rdelpoux/ESP32Robot/PCB/PCBdesign.md

# PCB design

## ESP 32

The chosen ESP32 is a ESP32-WROOM-32D and the datasheet is available [here](https://github.com/rdelpoux/ESP32Robot/blob/main/PCB/datasheets/esp32_wroom_32d_esp32_wroom_32u_datasheet_en-1365844.pdf). 

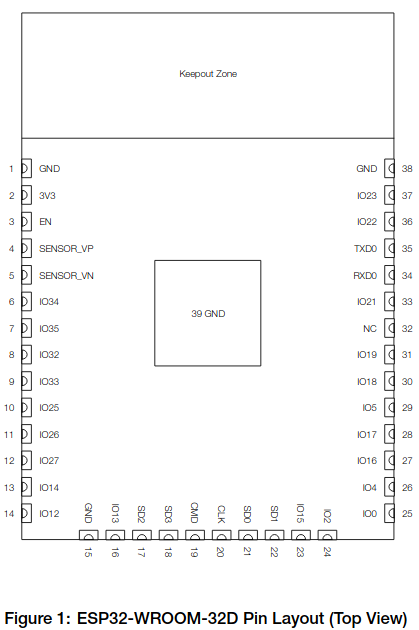
[picture p6: img/ESP32-WROOM-32D_Pin_Layout.png]


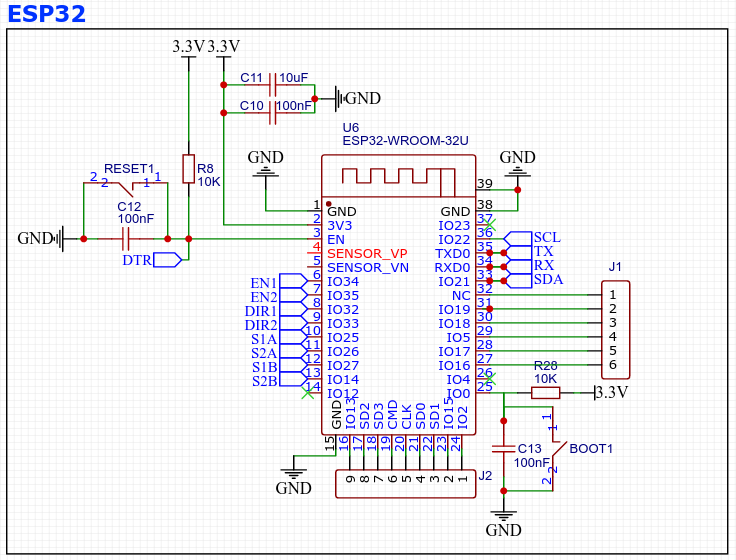
[picture p7: img/ESPPinout.png]
PinLayoutSheme


## Program upload

It was chosen to upload the program on the ESP32 using an [USB UART cable with FTDI chip](https://fr.rs-online.com/web/p/cables-raspberry-pi/7676200/). 

## Dual half bridge

The dual half bridge datasheet can be found [here](https://github.com/rdelpoux/ESP32Robot/blob/main/PCB/datasheets/pmoddhb1_sch.pdf).

The dual half bridge can be connected to the PCB. Pmod port is an open 12-pin interface arranged in 2 rows of 6 pins. The PCB include the following connector :  

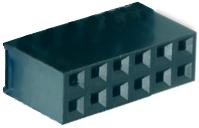
[picture p8: img/pmod.png]


The pins are arranged as : 

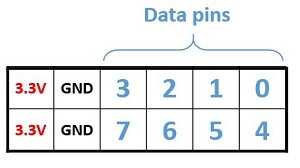
[picture p9: img/pmod_pins.jpeg]


For the Dual half bridge, the pins are the following :

| Data pins | Motor 1 | Data pins | Motor 2 |
| --- | --- | --- | --- |
| 0 | EN1 | 4 | EN2 |
| 1 | DIR1 | 5 | DIR2 |
| 2 | S1A | 6 | S2A |
| 3 | S1B | 7 | S2B |

## Battery Management

The system is powered by a [7.4V Lithium-Ion 2.6Ah](https://fr.rs-online.com/web/p/blocs-batteries-rechargeables/1449410/) battery. The PCB embed a battery charger. 

Charger example :

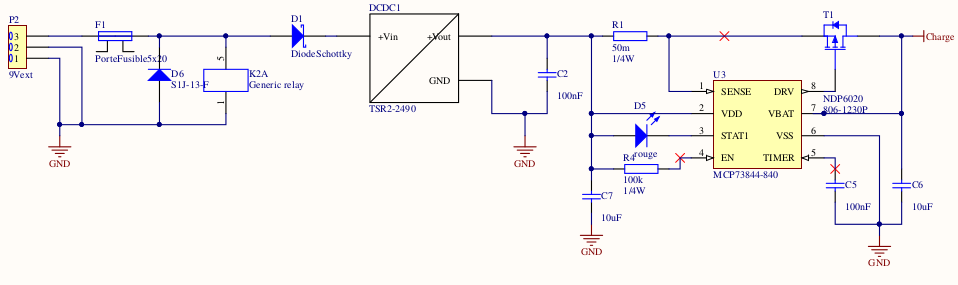
[picture p10: img/ChargeurBatterie.png]
