rdelpoux/ESP32Robot/SystemDescription.md

[Back to main page](/README.md)

# System description 

Dual-brige

[Back to main page](/README.md)

## System

The system is composed of 

- [2A-H-bridge](https://reference.digilentinc.com/reference/pmod/pmodhb5/reference-manual)

Dual-brige

- [Two motors with encoders](https://store.digilentinc.com/dc-motor-gearbox-1-53-gear-ratio-custom-6v-motor-designed-for-digilent-robot-kits/)

motor

- [7.4V Lithium-Ion 2.6Ah](https://fr.rs-online.com/web/p/blocs-batteries-rechargeables/1449410/) battery

- [Motor support](https://www.lextronic.fr/support-pour-moteurs-30627.html)

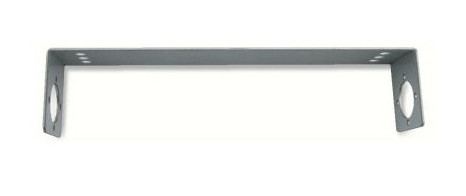
[picture p20: img/support-pour-moteurs.jpg]
support


- [Motor hubs](https://www.lextronic.fr/moyeux-pour-moteurs-pololu-30809.html)

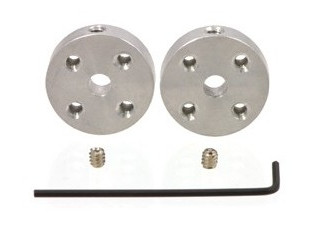
[picture p21: img/moyeux-pour-moteurs-pololu.jpg]
moyeux


- [60 mm wheels](https://www.lextronic.fr/paire-de-roues-diametre-60-mm-30817.html)

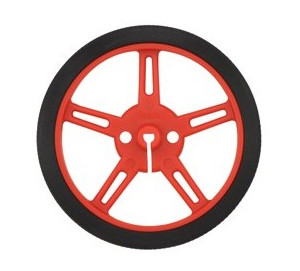
[picture p22: img/paire-de-roues-diametre-60-mm.jpg]
wheel


- [Free wheel](https://www.manomano.fr/catalogue/p/litzee-transfert-a-billes-roulettes-pour-meubles-roulettes-transfert-a-rouleaux-unites-de-transfert-a-billes-fer-galvanise-avec-b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)

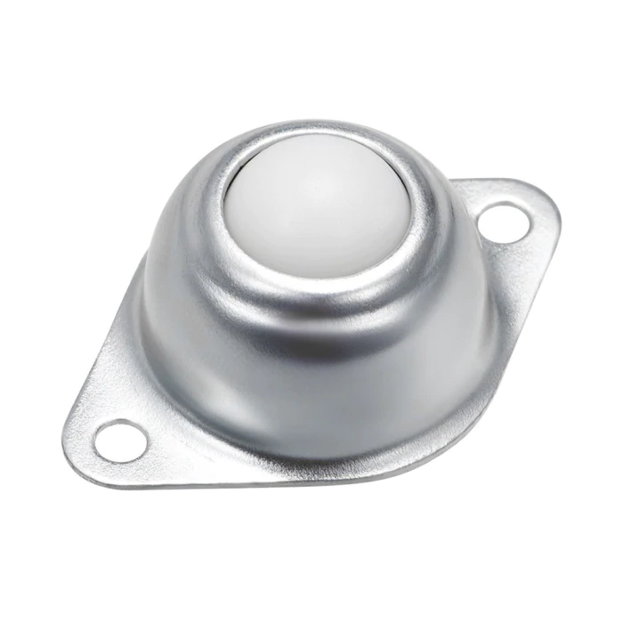
[picture p23: img/free-wheel.jpg]
free-wheel


[Back to main page](/README.md)

## Controller board

The chosen ESP32 is a ESP32-WROOM-32D and the datasheet is available [here](https://www.espressif.com/sites/default/files/documentation/esp32-wroom-32e_esp32-wroom-32ue_datasheet_en.pdf). It was  mounted on a custom PCB.

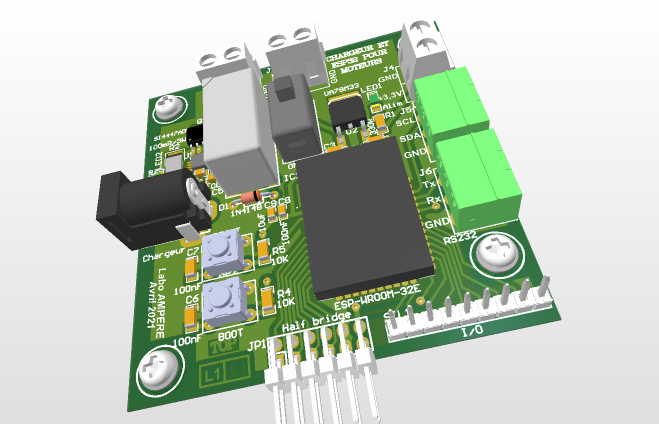
[picture p24: img/Chargeur_ESP32.png]


The PCB features are the following :

- Drive 2 DC motors
- Read 2 DC motors encoder
- Charge Battery

### PCB description

The principle scheme of the PCB is :

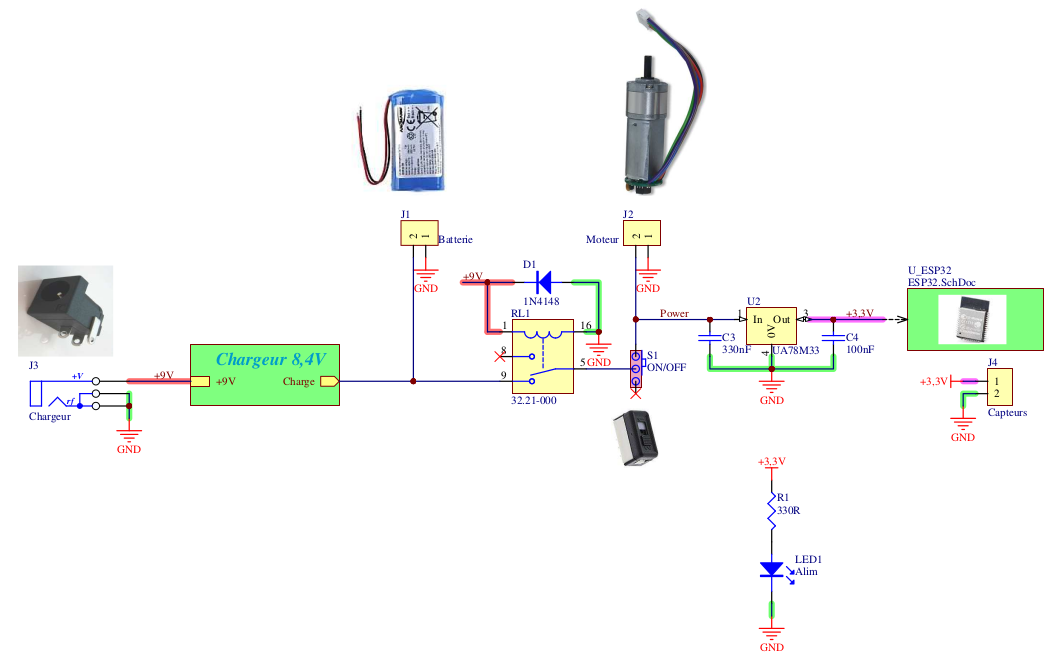
[picture p25: img/PCBPrinciple.png]


Specifically, the routing of the ESP 32 is 

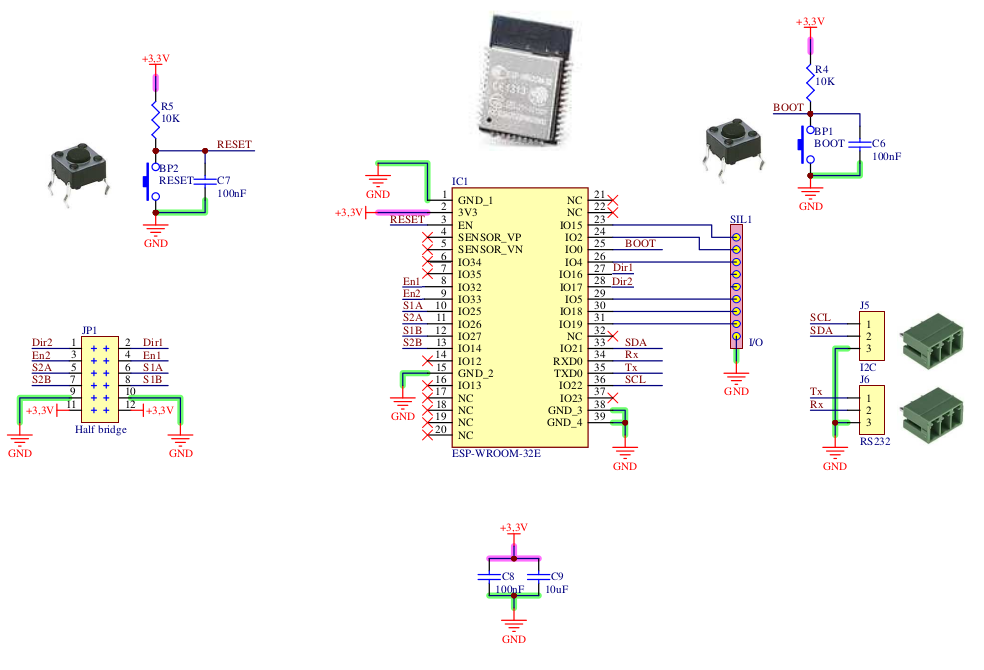
[picture p26: img/ESPMod.png]


### Pinout

| Name | Description | ESP32  Pinout |
| ---- | --- | --- |
| Dir1 | Motor 1 direction (0 forward, 1 reverse) | IO16 |
| Dir2 | Motor 2 direction (0 forward, 1 reverse) | IO17 |
| En1  | Enable motor 1 (PWM) | IO32 |
| En2  | Enable motor 2 (PWM) | IO33 |
| S1A  | Motor 1 Sensor A feedback pin | IO25 |
| S1B  | Motor 1 Sensor B feedback pin | IO27 |
| S2A  | Motor 2 Sensor A feedback pin | IO26 |
| S2B  | Motor 2 Sensor B feedback pin | IO14 |

### Program Upload

It was chosen to upload the program on the ESP32 using an [USB UART cable with FTDI chip](https://fr.rs-online.com/web/p/cables-raspberry-pi/7676200/). 

When try to upload a new sketch to your ESP32 in the Arduino IDE, it may fail to connect to your board saying ‘**A fatal error occurred: Failed to connect to ESP32: Timed out waiting for packet header**’.

Dual-brige

Hold-down the **RESET** and **BOOT** button in your ESP32 board, then release  **RESET** then **BOOT** button. The ESP32 enters **BOOT** mode. After uploading a new sketch, press the **RESET** button to restart the ESP32 and run the new uploaded sketch.

[Back to main page](/README.md)

## Sources 

- [https://lastminuteengineers.com/esp32-arduino-ide-tutorial/](https://lastminuteengineers.com/esp32-arduino-ide-tutorial/)

[Back to main page](/README.md)
