rdelpoux/ESP32Robot/img/encoder.jpg

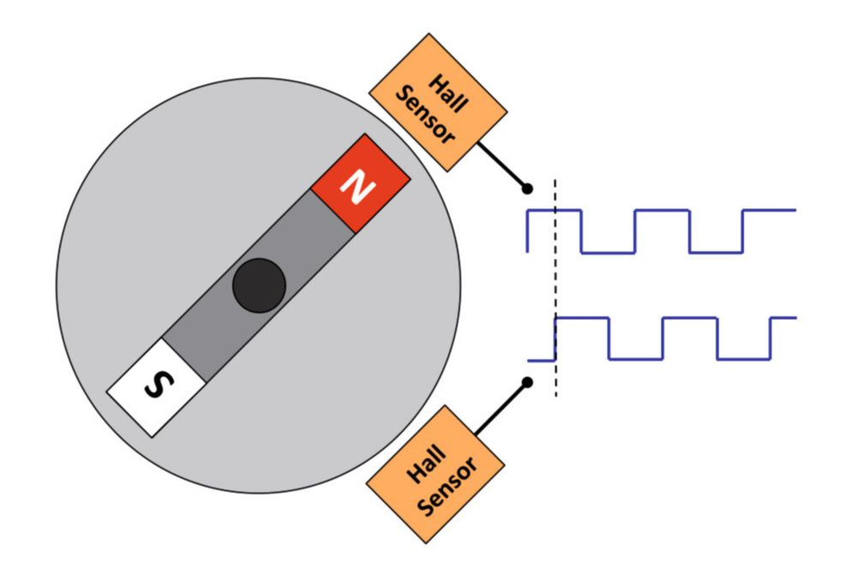
img/encoder.jpg
