rdelpoux/ESP32Robot/img/hbridge_logic_enable.png

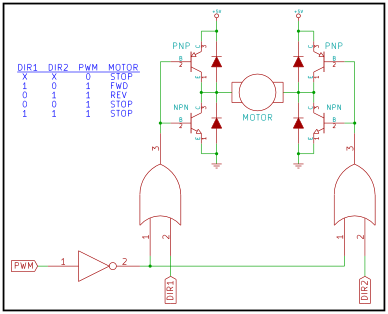
img/hbridge_logic_enable.png
