rdelpoux/ESP32Robot/img/moteur-reducteur-avec-encodeur.jpg

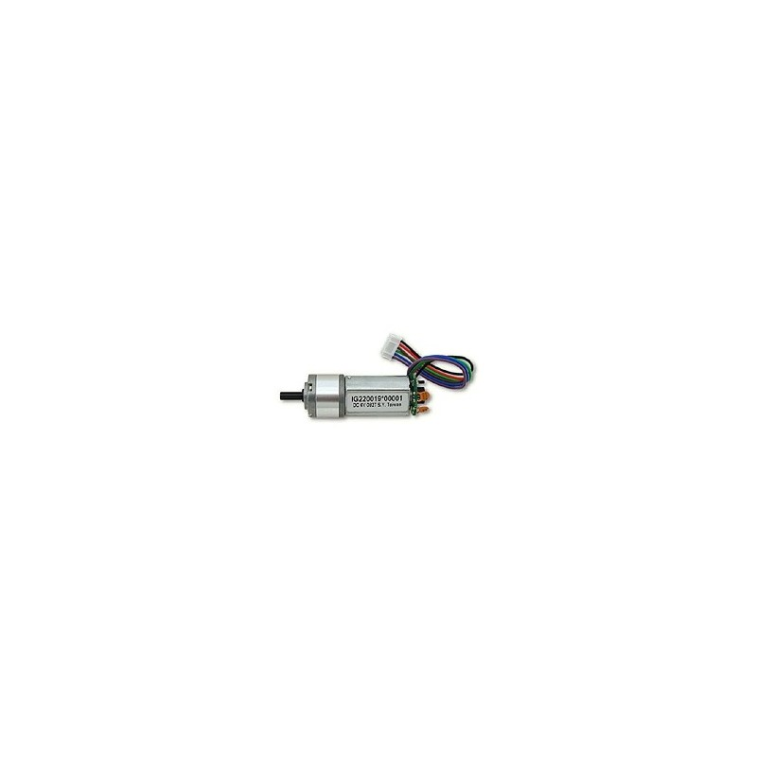
img/moteur-reducteur-avec-encodeur.jpg
