rdelpoux/ESP32Robot/img/Pmod_DHB1.png

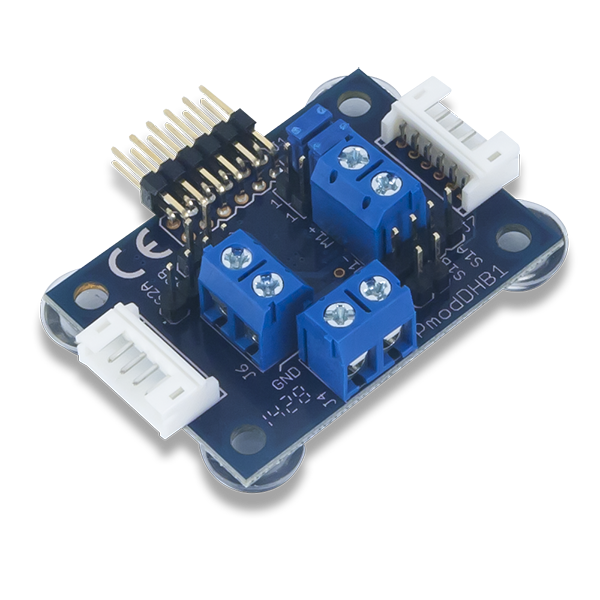
img/Pmod_DHB1.png
