rdelpoux/ESP32Robot/img/Pmoddhb1_Connector.png

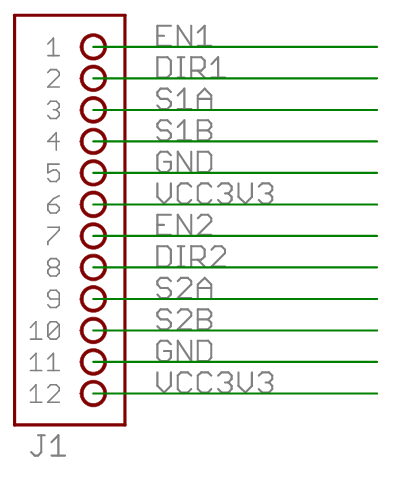
img/Pmoddhb1_Connector.png
