rdelpoux/ESP32Robot/img/td_libs_Encoder_pos1.png

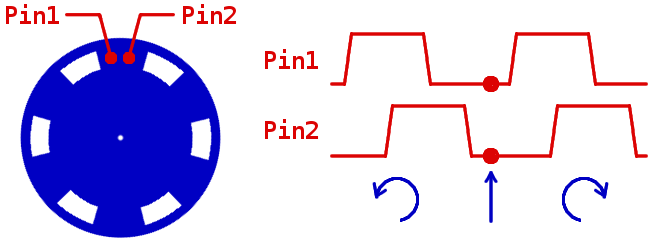
img/td_libs_Encoder_pos1.png
