rdelpoux/ESP32Robot/img/td_libs_Encoder_pos2.png

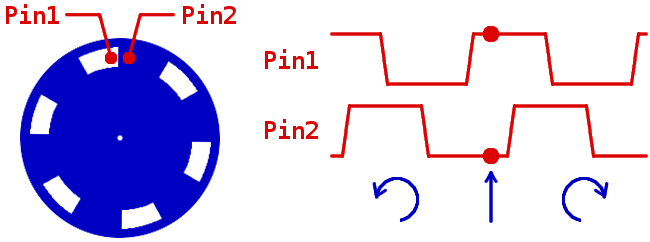
img/td_libs_Encoder_pos2.png
