rdelpoux/ESP32Robot/img/td_libs_Encoder_pos3.png

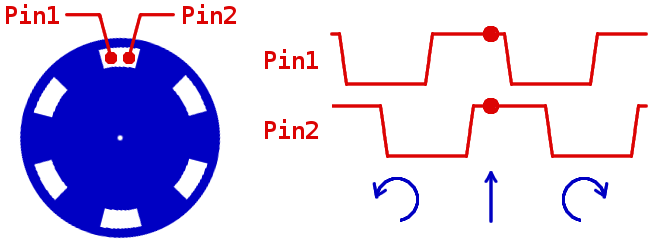
img/td_libs_Encoder_pos3.png
