rdelpoux/ESP32Robot/img/td_libs_Encoder_pos4.png

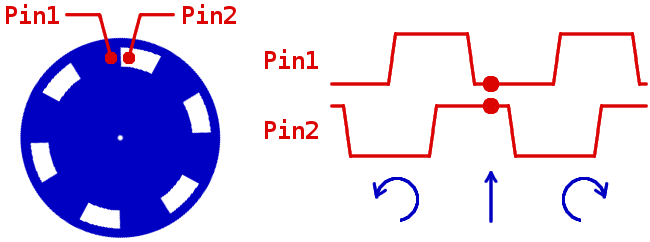
img/td_libs_Encoder_pos4.png
