rdelpoux/ESP32Robot/(commit log)

2021-02-09 datasheets + pmod connector
2021-02-09 Batterie chargueur
2021-02-09 PCB description
2021-04-21 update motor drive
2021-04-22 Control and Encoder
2021-04-28 Pull Up Resistor
2023-05-16 Code for camera empty with recurence
2025-03-18 add arduino tutorial
2025-03-18 add arduino tuto
2026-03-10 ESP32 config
